ArthurSabadini/eecs3216-bldc-motor-driver/Reports/EECS 3216 Project Report.pdf

# EECS 3216 Finale Project Report: BLDC Motor Driver

### Syed Mustafa Jamal, Student Number: 217761651 Arthur Sabadini Nascimento, Student Number: 220007175 Muhammad Khan, Student Number: 218047621

### March 30 - April 21, 2025

1

## Contents

1 Abstract | 4
2 Analysis Correction | 5
3 Helper Modules | 6
4 Software Design | 11
5 Hardware Design | 20
6 Components | 23
7 Simulations | 24
8 Testing | 26
9 Implemented Circuit | 34
10 Challenges | 35
11 Measurements | 36

2

12 Addressing the Damping Effect | 38
13 Conclusion | 38
References | 39
14 External Resources | 40

3

## Abstract

Our project is about a driver for a three-phase BLDC motor. We will implement SVPWM (space vector PWM) to control the three phases of the motor. We will also implement an inverter with discrete components (capacitors, transistors, flyback diodes, etc) in order to demonstrate the driver working, using an RC low-pass filter and oscilloscope probes.

Our project operates on the software side, where we generate three distinct PWM signals using the SVPWM algorithm to maximize the power delivered to the load. These PWM signals would be fed to an inverter (we implemented that with discrete components), and the inverter would control a higher voltage source to deliver more power to the motor (our load) to drive it. As described before, the internal impedance of the motor behaves as a low-pass filter, so the output of the inverter is converted to a sinusoidal input to the motor.

4

## Analysis Correction

We must address the analysis of our proposal. During testing, we noticed that the motor was moving when being driven by the system, but not completely rotating. This is because we neglected the stationary torque of the motor. Due to our approach being an open loop, the only way we could correct this was to increase the MOSFET’s (switches) gate voltage to increase the current delivered. The corrected space-state equations are

(Torque and Speed Controlling of a PMSM/BLDC Using Simulink and SOLO Blockset, 2022) [1].

d
dt

ia
ib
ic
ω

=

−R/L | 0 | 0 | −keΨa/L
0 | −R/L | 0 | −keΨb/L
0 | 0 | −R/L | −keΨc/L
keΨa/J keΨb/J keΨc/J | −B/J

ia
ib
ic
ω

+

1/L | 0 | 0 | 0
0 | 1/L | 0 | 0
0 | 0 | 1/L | 0
0 | 0 | 0 | 1/J

Va
Vb
Vc
TL

(Lee et al., 2023) [2]

Please refer to our project proposal for the full analysis. Note that now there is an extra input dependency: the motor’s load torque. We do not have the equipment to measure it, but we can remedy that in our open-loop approach by increasing the MOSFET’s gate voltage to increase the current delivered to the motor. We address the circuitry changes in the hardware design section.

5

## Helper Modules

### debouncer.sv

This module was used to debounce the input buttons Key1 and Key0, to be used as inputs in the next modules. For the following FSM, the inputs denote the button press and the completion of the debouncing period. The output is the stable signal of the button press; we denote an input that is not important as x.

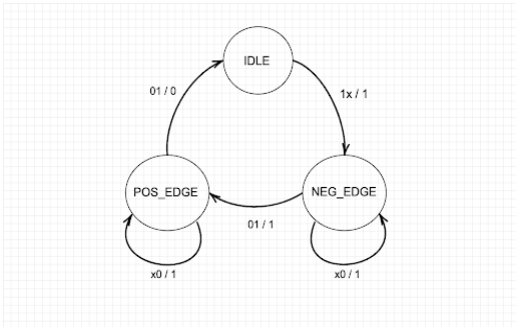
[picture p2: figure]

Figure 1: debouncer FSM

When a button is pressed, we go from IDLE to NEG EDGE, drive the output high, and keep it in NEG EDGE for the duration of the debouncing period. After completion of the debouncing period, and on the next (unstable) positive edge of the button, we go to POS EDGE, and the functionality is the same. However, after the debouncing period is completed, we drive the output low and go back to IDLE.

6

### inputDriver.sv

This module is responsible for synchronization of the button press signals (to avoid metastability) and for detecting when both buttons are pressed at the “same” time (given a synchronization window). It is composed of four states: LISTEN, KEY0 PRESSED, KEY1 PRESSED and BOTH PRESSED. A SYNC DELAY is defined to synchronize the presses of the (debounced) inputs Key0 and Key1, we assume that if a user pressed Key0, and in the next SYNC DELAY amount of time (we chose 50ms for our usecase) also presses Key1, then we assume that the user pretended to press both buttons at the same time.

Below is the Mealy FSM design for this module. For input bits, we use Key1 = third bit, Key0 = second bit, and for the first bit we define it as 1 if the internal timer counter equals the SYNC DELAY, else if the timer is less than that we define it as 0; the timer can never be bigger than SYNC DELAY, we ensure this in the interval logic. The output is organized as Key1 Pressed, Key0 Pressed, Both keys Pressed and is used in other modules.

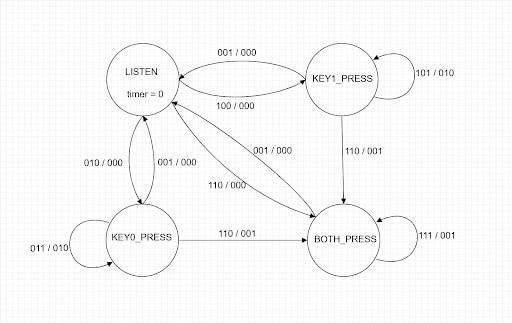
[picture p3: figure]

Figure 2: inputDriver FSM

7

The initial state is always LISTEN, where we wait for input. Suppose the user pressed Key1, then we would go to state KEY1 PRESS and wait for the timer to equal SYNC DELAY. If the user keeps pressing the same key until then, we stay in the current state KEY1 PRESS and update the output to 010, which represents that key1 has been pressed. Else, if before that, the user also presses key0, the FSM will transition to BOTH PRESS, updating the output to 001, representing that both keys have been pressed. When the user releases any buttons, after some synchronization delay, the module will return to the LISTEN state, waiting for new inputs.

8

### Driver.sv

This module was used to interact with a user, get inputs, modify the parameters of the generated signals, such as frequency, amplitude, and dead time, and turn the signal on and off. There are three possible configurations: Frequency configuration, Amplitude configuration and Dead Time configuration, together with two input buttons Key1 and Key0.

When Key0 is pressed, the module changes the value according to the current configuration (i.e. if in Frequency configuration, it changes the signal’s frequency), and Key1 is used to activate/deactivate the output signal. When both keys are pressed (for this we used the previously explained module inputDriver.sv), the module goes to the next configuration; from Frequency to Amplitude, Amplitude to Dead Time, and Dead Time back to Frequency.

Options are 3Hz, 5Hz, 6Hz, 7Hz and 8Hz.

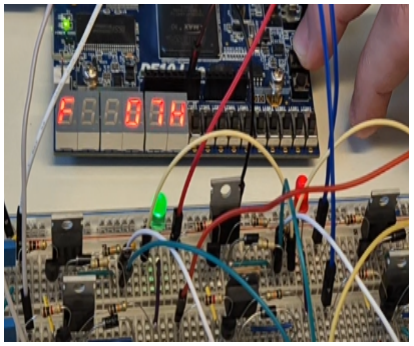
[picture p4: figure]

Figure 3: Frequency Configuration UI

9

Options are 20%, 40%, 60%, 80% and 100%.

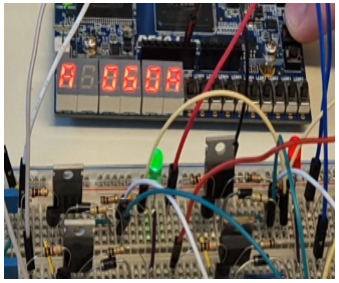
[picture p5: figure]

Figure 4: Amplitude Configuration UI

Options are 300ns, 500ns, 700ns, 1us and 3us.

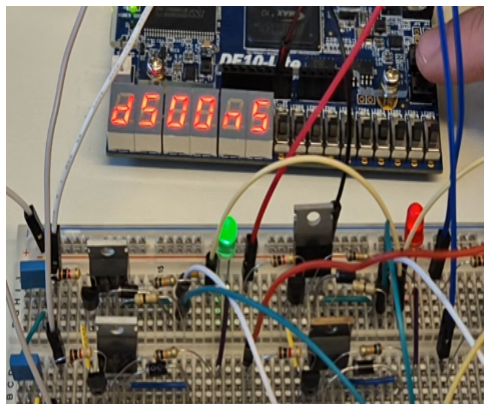
[picture p6: figure]

Figure 5: Dead Time Configuration UI

10

## Software Design

### Algorithm Explanation

We chose to implement the Space Vector Pulse Width Modulation (SVPWM) algorithm for this project. In SVPWM, instead of generating sinusoidal PWM signals offset by 120 degrees, the duty cycle and period of the outputs are controlled by a sector and a corresponding (preset) vector sequence.

Each sector corresponds to 6 sectors (of 60 degrees each) of a circle, the space vectors correspond to the codified output of the three phases (i.e. for a vector = 100, output 1 is high and outputs 2 and 3 are low).

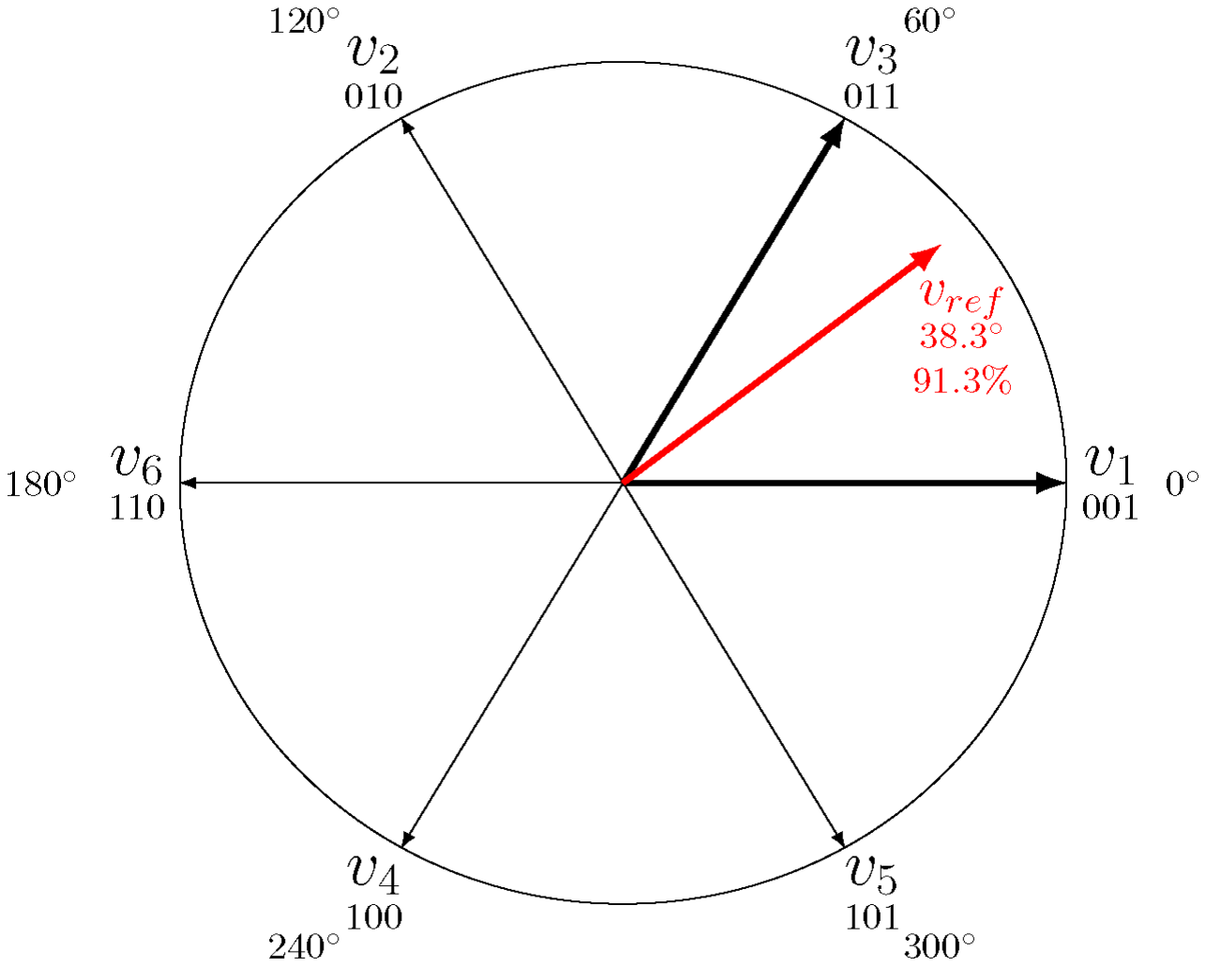
[picture p7: figure]

Figure 6: (Space Vector PWM Intro, 2017) [10]

Using a look-up table with sine wave values, we can use the SVPWM algorithm to represent any voltage vector in the above diagram (limited by the look-up table resolution)! The SVPWM algorithm was chosen (instead of SPWM) because it can maximize the power delivered to the load; SPWM can deliver 50% of power, while SVPWM, 86%

The output of this module is labelled S; the first three LSBs (bits 0 - 2) are the top output of the inverter, and the last three MSBs (bits 5 - 3) are the reversed lower outputs of the inverter. The outputs are arranged so that the inverse of bit 0 is bit 3, bit 1 is bit 4, and bit 2 is bit 5.

11

### Implementation

We created a module SVPWM.sv, which takes 5 inputs, 3 of which are amplitude, frequency and dead time configurations. This module was responsible for generating the 3 outputs and their inverse counterparts with dead time (so as not to short the power supply).

1 | module SVPWM (
2 | input wire clk ,
3 | input wire active ,
4 | input wire [6:0] AMPLITUDE ,
5 | input wire [13:0] FREQ ,
6 | input wire [13:0] DEAD_TIME_US ,
7 | output reg [5:0] S
8 | );
Listing 1: Module Definition

We had to sample a base sine wave to implement an open-loop system. For that, we created a sine look-up table with 102 samples (the reason why 102 specifically will be explained shortly).

15 | // Samples at 1 kHz . Normalized in units of clock cycle at 50 MHz
16 | localparam reg [15:0] SIN_LUT [0: SAMPLES -1] = ’{
17 | 16 ’ d24999 , 16 ’ d26538 , 16 ’ d28071 , 16 ’ d29593 , 16 ’ d31097 , 16 ’ d32578 , 16 ’
d34030 , 16 ’ d35448 , 16 ’ d36826 , 16 ’ d38160 , 16 ’ d39443 , 16 ’ d40672 ,
18 | 16 ’ d41841 , 16 ’ d42946 , 16 ’ d43984 , 16 ’ d44949 , 16 ’ d45839 , 16 ’ d46649 , 16 ’
d47378 , 16 ’ d48021 , 16 ’ d48577 , 16 ’ d49044 , 16 ’ d49420 , 16 ’ d49703 ,
19 | 16 ’ d49892 , 16 ’ d49987 , 16 ’ d49987 , 16 ’ d49892 , 16 ’ d49703 , 16 ’ d49420 , 16 ’
d49044 , 16 ’ d48577 , 16 ’ d48021 , 16 ’ d47378 , 16 ’ d46649 , 16 ’ d45839 ,
20 | 16 ’ d44949 , 16 ’ d43984 , 16 ’ d42946 , 16 ’ d41841 , 16 ’ d40672 , 16 ’ d39443 , 16 ’
d38160 , 16 ’ d36826 , 16 ’ d35448 , 16 ’ d34030 , 16 ’ d32578 , 16 ’ d31097 ,
21 | 16 ’ d29593 , 16 ’ d28071 , 16 ’ d26538 , 16 ’ d24999 , 16 ’ d23460 , 16 ’ d21927 , 16 ’
d20405 , 16 ’ d18901 , 16 ’ d17420 , 16 ’ d15968 , 16 ’ d14550 , 16 ’ d13172 ,
22 | 16 ’ d11838 , 16 ’ d10555 , 16 ’ d9326 , 16 ’ d8157 , 16 ’ d7052 , 16 ’ d6014 , 16 ’
d5049 , 16 ’ d4159 , 16 ’ d3349 , 16 ’ d2620 , 16 ’ d1977 , 16 ’ d1421 ,
23 | 16 ’ d954 | , 16 ’ d578 | , 16 ’ d295 | , 16 ’ d106 | , 16 ’ d11 | , 16 ’ d11 | , 16 ’
d106 | , 16 ’ d295 | , 16 ’ d578 | , 16 ’ d954 | , 16 ’ d1421 , 16 ’ d1977 ,
24 | 16 ’ d2620 , 16 ’ d3349 , 16 ’ d4159 , 16 ’ d5049 , 16 ’ d6014 , 16 ’ d7052 , 16 ’
d8157 , 16 ’ d9326 , 16 ’ d10555 , 16 ’ d11838 , 16 ’ d13172 , 16 ’ d14550 ,
25 | 16 ’ d15968 , 16 ’ d17420 , 16 ’ d18901 , 16 ’ d20405 , 16 ’ d21927 , 16 ’ d23460
26 | };
Listing 2: Sine Look-Up Table

12

FSMs

There were two FSMs in the SVPWM module, one FSM for each sector and another for each vector.

28 | typedef enum logic [2:0] { S1 , S2 , S3 , S4 , S5 , S6 } state_sector ;

29
30 | typedef enum logic [2:0] {
31 | V0 = 3’ b000 , V1 = 3’ b100 , V2 = 3 ’ b110 , V3 = 3’ b010 ,
32 | V4 = 3’ b011 , V5 = 3’ b001 , V6 = 3 ’ b101 , V7 = 3’ b111
33 | } state_vector ;
Listing 3: Sector and Vector FSM

We defined a look-up table for the vector sequence for each sector. Each sequence was chosen so only 1 bit is changed on each vector transition. This was needed to minimize switching losses on the MOSFETs and BJTs transistors.

35 | localparam state_vector SECTOR_VECTORS_LUT [0: NUMBER_STATES -1][0:
| NUMBER_VECTORS -1] = ’{
36 | ’{V0 , V1 , V2 , V7 , V2 , V1 , V0 }, ’{V0 , V3 , V2 , V7 , V2 , V3 , V0 } ,
37 | ’{V0 , V3 , V4 , V7 , V4 , V3 , V0 }, ’{V0 , V5 , V4 , V7 , V4 , V5 , V0 } ,
38 | ’{V0 , V5 , V6 , V7 , V6 , V5 , V0 }, ’{V0 , V1 , V6 , V7 , V6 , V1 , V0 }
39 | };
Listing 4: Vectors Sequence

13

Parameters Calculations

As mentioned in our proposal, the time allocated to each vector in a sequence goes as

T1 =

Ts √
3

sin(θ − π/3)

T2 =

Ts √
3

sin(θ)

T3 = Ts − (T1 + T2)

We implemented these values in the software as follows

58 | // SVPWM parameters calculations
59 | reg [6:0] TIME = 0;
60 | reg [17:0] AMP ;
61 | reg [32:0] T0 , T1 , T2 ;

62
63 | // Normalizing by 100 and Dividing by sqrt {3}
64 | // Note 2^19 */(100* sqrt {3}) = 0 xBD2
65 | assign AMP = ( AMPLITUDE * SAMPLE_PERIOD * 40 ’ hBD2 ) >> 19;

66
67 | // Normalizing by max SIN_LUT value = 49999
68 | assign T1 = AMP * SIN_LUT [ TIME % SAMPLES ] / 49999;
69 | assign T2 = AMP * SIN_LUT [( TIME + ( SAMPLES * 120 / 360) ) % SAMPLES ] /
| 49999;
70 | assign T0 = SAMPLE_PERIOD - ( T1 + T2 );
Listing 5: Periods Calculations

We defined the amplitude AMP=Ts/

√
3 where Ts is the Sample Period. To compute that in software, note that 2¹⁹/(100 ·

√
3) = 0xBD2 (we divided
by 100 to account for the variable amplitude) we multiply the input ‘AMPLI-TUDE’ by this quantity and shift back by 19 (19 was chosen to get enough precision) to compute AMP.

This was needed since the DE10-Lite board does not support floatingpoint operations. Also note that we shift the argument of ‘T2’ forwards by SAMPLES/6 since we cannot shift T1 back by the same amount; over time, this has the same effect as the original formulas.

14

State Updates

The following code is inside an ‘always comb’ block. This block is called whenever the corresponding counters are incremented.

75 | always_comb begin
76 | case ( CURR_SEC )
77 | S1 : begin
78 | NEXT_SEC = ( sector_counter < SECTOR_PERIOD )? S1 : S2 ;
79 | NEXT_VEC = SECTOR_VECTORS_LUT [0][ vector_index ];
80 | end
81 | S2 : begin
82 | NEXT_SEC = ( sector_counter < SECTOR_PERIOD )? S2 : S3 ;
83 | NEXT_VEC = SECTOR_VECTORS_LUT [1][ vector_index ];
84 | end
85 | S3 : begin
86 | NEXT_SEC = ( sector_counter < SECTOR_PERIOD )? S3 : S4 ;
87 | NEXT_VEC = SECTOR_VECTORS_LUT [2][ vector_index ];
88 | end
89 | S4 : begin
90 | NEXT_SEC = ( sector_counter < SECTOR_PERIOD )? S4 : S5 ;
91 | NEXT_VEC = SECTOR_VECTORS_LUT [3][ vector_index ];
92 | end
93 | S5 : begin
94 | NEXT_SEC = ( sector_counter < SECTOR_PERIOD )? S5 : S6 ;
95 | NEXT_VEC = SECTOR_VECTORS_LUT [4][ vector_index ];
96 | end
97 | S6 : begin
98 | NEXT_SEC = ( sector_counter < SECTOR_PERIOD )? S6 : S1 ;
99 | NEXT_VEC = SECTOR_VECTORS_LUT [5][ vector_index ];
100 | end
101 | endcase
Listing 6: State Updates

We can see that the update of ‘NEXT SEC’ and ‘NEXT VEC’ is based on a straightforward type II state machine. ‘NEXT PREDICT VEC’is used for the dead time implementation, This will be explained shortly.

In the same block, the top output of the inverters defined as

109 | // Inverting ( top ) Output
110 | // If not active (on an emergency stop for example ) hard set top values
| to 1 to turn off
111 | S [2:0] = active ? ~ CURR_VEC : 3’ b111 ;
112 | end
Listing 7: Top Output

If we are in the active state (‘active’ is an input to the module), the top output is the inverted current vector; we inverted the logic after implementing a voltage shifter circuit, which will be covered in the hardware section.

15

Vector Period Calculations

Vector periods are the periods in which each vector must be active. The following code shows how we implemented it.

117 | // Period Update
118 | always_comb begin
119 | case ( vector_index )
120 | 0: VECTOR_PERIOD = T0 / 4;
121 | 1: VECTOR_PERIOD = T1 / 2;
122 | 2: VECTOR_PERIOD = T2 / 2;
123 | 3: VECTOR_PERIOD = T0 / 2;
124 | 4: VECTOR_PERIOD = T2 / 2;
125 | 5: VECTOR_PERIOD = T1 / 2;
126 | 6: VECTOR_PERIOD = T0 / 4;
127 | default : VECTOR_PERIOD = T0 / 4;
128 | endcase
129 | end
Listing 8: Period Updates

In the above code, we allocated the first, middle and last vectors as zero vectors, no current will be flowing during the time allocated for T0. We can also see that the second, third, fifth and sixth vectors are active. This time allocation would allow us to generate the following voltage diagram (for the first sector, S1).

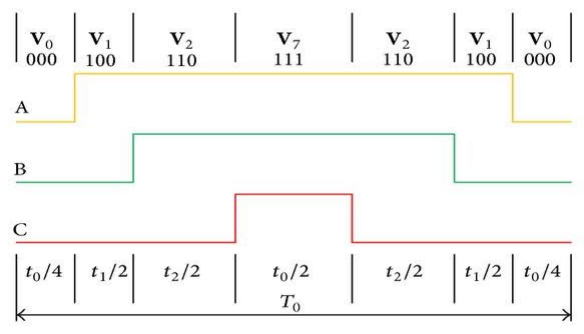
[picture p8: figure]

Figure 7: (Switching Sequence of Traditional SVPWM., n.d.) [10]

A similar voltage pattern would be implemented for each sector, however, the voltage distribution would change.

16

State Transitions

If the user presses the (debounced) reset button on its negative edge, we immediately deactivate the lower outputs of the inverter (bits 3- 5) by writing 1s to them (due to the inverted logic); this would turn off the whole operation. Else, while we are active, we keep incrementing the counters and other parameters normally.

131 | // States Transitions
132 | always_ff @( posedge clk or negedge active ) begin
133 | if (~ active ) begin
134 | // If not active (on an emergency stop for example ) hard set bottom
| values to 1 to turn off
135 | S [5:3] <= 3’ b111 ;
136 | end else begin
137 | sector_counter <= ( sector_counter < SECTOR_PERIOD )? sector_counter +
| 1: 0;

138
139 | // Forcefully reset parameters
140 | // Output may be out of sync if frequency is not a divisor of system
| clock (50 MHz )
141 | if (( sample_counter >= SAMPLE_PERIOD ) | ( sector_counter >=
| SECTOR_PERIOD ) ) begin
142 | vector_counter <= 0;
143 | vector_index <= 0;
144 | sample_counter <= 0;
145 | TIME <= ( TIME + 1) % SAMPLES ;
Listing 9: State Transitions

We reset parameters when transitioning between samples and sectors. This answers why we chose an oddly specific number of samples at the beginning of the report (102 sine lut samples). Since we have 6 sectors, we’d like to go through an equal number of samples per sector.

On the positive edge of the clock, we update the parameters normally. We increment ‘vector counter’ until it reaches ‘VECTOR PERIOD’, we only increment the vector index when a vector period is finished.

147 | // Incrementing parameters
148 | end else begin
149 | vector_counter <= ( vector_counter < VECTOR_PERIOD )? vector_counter +
| 1: 0;
150 | sample_counter <= sample_counter + 1;

151
152 | // Only increment vector_index at the end of the vector period
153 | if( vector_counter >= VECTOR_PERIOD ) vector_index <= ( vector_index +
1) % ( NUMBER_VECTORS );
154 | end
Listing 10: Parameter Updates

17

Dead Time

Dead time is the period in which both the top and bottom outputs of the inverter are off, so that we may avoid shorting the power supply. To implement this, we must know what the next vector is in the sequence.

If the next bit is a 1, and the current signal is also a 1, this signal must be flipped to a 0 before the vector transition so as not to short the power supply.

156 | // Dead Time I m p l e m e n t a t i o n for Non - Inverting ( bottom ) Output
157 | // Fist output is undefined , implement a pull down resistor .
158 | if( vector_counter >= ( VECTOR_PERIOD - ( DEAD_TIME_PERIOD ) )) begin
159 | // Initially both signals ( top and bottom ) are 0 , and suppose the
| top output
160 | // goes to 1 at the beggining of a vector transition . The bottom
| signal waits for
161 | // D E A T _ T I M E _ P E R I O D / 2 at the end of the cycle and makes a
| prediction of what the next vector will be
162 | // ( really we know what it is since the vector sequence is fixed ).
163 | // If the prediction is correct we assign the vector value to the
| bottom output
164 | // ( since the top output is inverted ) else we set it to 0 for safety

165
166 | S [3] <= ( NEXT_PREDICT_VEC [0] == CURR_VEC [0]) ? NEXT_PREDICT_VEC [0]:
| 0;
167 | S [4] <= ( NEXT_PREDICT_VEC [1] == CURR_VEC [1]) ? NEXT_PREDICT_VEC [1]:
| 0;
168 | S [5] <= ( NEXT_PREDICT_VEC [2] == CURR_VEC [2]) ? NEXT_PREDICT_VEC [2]:
| 0;
169 | end else if( vector_counter >= DEAD_TIME_PERIOD ) begin
170 | // After the initial D E A D _ T I M E _ P E R I O D we set the bottom output to
| the current vector value
171 | // ( since top output is inverted ).
172 | S [5:3] <= CURR_VEC ;
173 | end
Listing 11: Dead Time Implementation

18

There are two important moments for the dead time signals. When the counter reaches ‘VECTOR PERIOD - DEAD TIME PERIOD’, this is the end of the previous cycle, where we must ‘predict’ what the next output is going to be.

If the prediction is equal to the current value of the signal, we make no changes, we reset to 0. The other important moment is the the counter reaches ‘DEADT TIME PERIOD’ in the beginning of the cycle, in which the dead time has completed, so we can invert the current value of the top signal and write it to the lower signal (since the output is inverted, the lower signals equals the bits of the current vector). The following figure best demonstrates the logic.

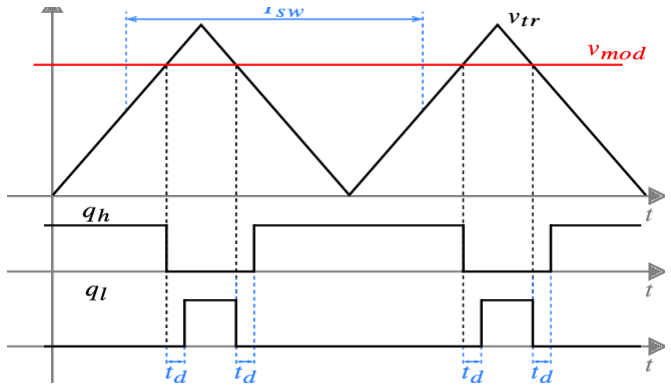
[picture p9: figure]

Figure 8: (Fig. 6. Dead-Time Generation on the Inverter Control Signals by the PWM..., n.d.) [7]

19

## Hardware Design

The hardware design was inspired by common inverter topologies, such as this one.

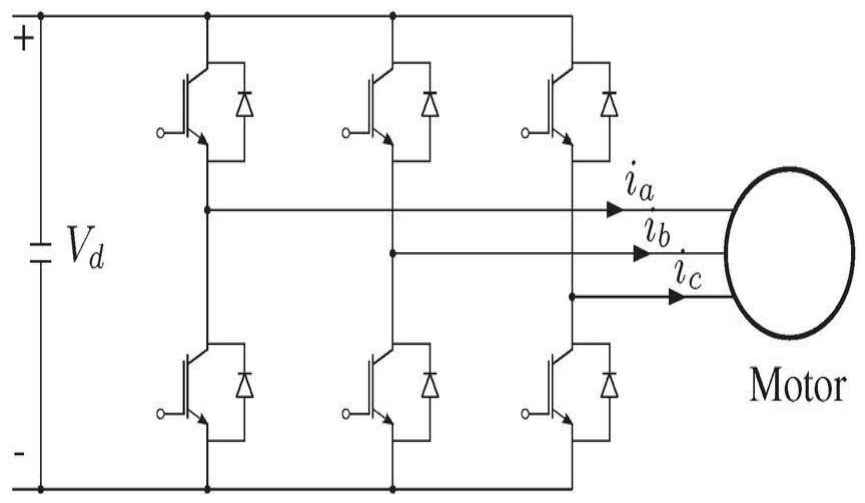
[picture p10: figure]

Figure 9: Design Topology

(Fig. 2. Three Phase Inverter Topology, n.d.) [6]

We chose the IRF520 MOSFET to act as switches (in the saturation region) since the DE10-Lite can’t provide enough current to operate BJTs. MOSFETs can handle higher currents, which are needed to drive the motor. The following was our initial circuit design.

20

### Previous Circuit Design

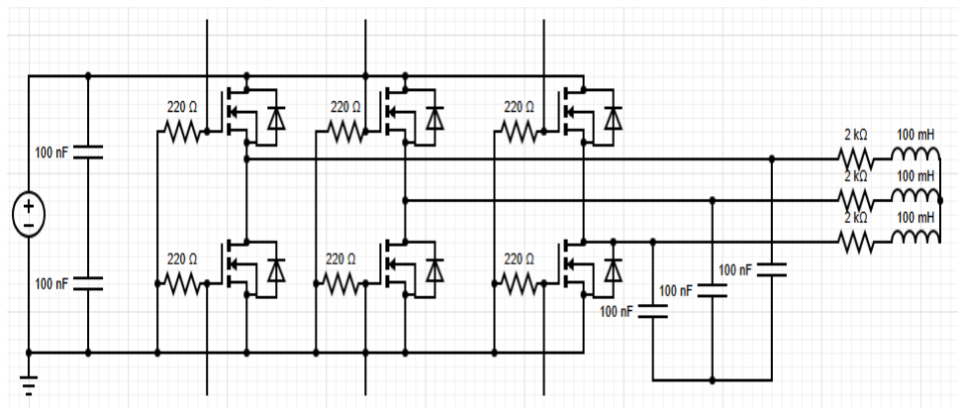
[picture p11: figure]

Figure 10: First Circuit Design

The hanging wires would be directly connected to the outputs of the DE10-Lite with the SVPWM software loaded. We implemented pull-down resistors at the gate of each MOSFET to ensure that all components would be initially off, and the three-phase resistors with inductors connection simulate the impedance of the motor, the diodes across the MOSFETs are to ensure that the back EMF of the motor do not damage the MOSFETs; even though they already have built in reverse diodes, we did not know what the magnitude of the back EMF could be, so we added the diodes for redundancy. We also implemented the capacitors connected in a star configuration; those were mostly used for debugging and visualizing the raw output waves.

21

### Improved Circuit Design

The circuitry mostly worked, however, we noticed that we were not getting enough current through the motor, and as a result, the motor did not fully move. This was the case because the voltage logic level of the DE10-Lite (3.3V) was too low to turn on the MOSFETs completely. For this reason, we decided to add extra circuitry to the MOSFETs gate input to shift up the voltage. Follows the improved (and final) circuitry.

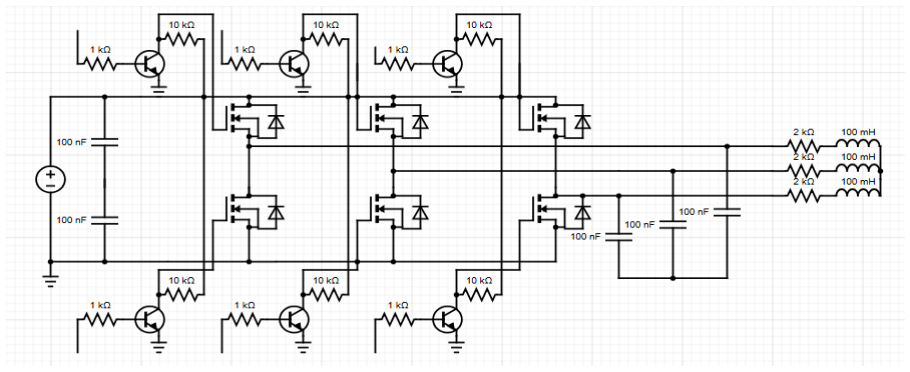
[picture p12: figure]

Figure 11: Final Circuit Design

The new circuitry design implements discrete NOT gates on the MOSFET inputs (hence why we reversed the logic on the software); now, there’s no need for pull-down resistors since the BJTs internal diodes already act as pull-downs. This way, we can shift the logic voltage of the DE10-Lite from 3.3V to 5V, fully turning on the MOSFETs.

This new circuitry does technically consume more power due to the not gates being on when the system is off. However, the choice of 10kOhms collector and 1KOhms base resistors was done intentionally to make sure the BJTs remain in the saturation region with a collector current of 500uA (assuming a source of 5V for the BJTs), which implies a total current consumption of 3mA when the system is off.

22

## Components

For the inverter switches, we used the IRF520 MOSFETs (Irf520.Pdf, n.d.) [8], which have an on resistance of about 0.27 Ohms and a gate voltage threshold between 2V - 4V (this is why we had to introduce extra circuitry to shift the logic voltage level of the DE10-Lite of 3.3V) the on resistance seems to be high, but on testing we noticed the MOSFETs were not heating up at all. However, the IRF520 is commonly used for high-frequency switching applications, such as for this project.

For the transistor used in the discrete not-gates, we used a combination of BC547B (alldatasheet.com, n.d.) [4] with a beta value of around 290 (which is widely used for switching applications) and the 2A2222A-1726 (P2N2222A
- Amplifier Transistors NPN Silicon, n.d.) [9] with a beta value of around 200; the 2A2222 is mostly used for amplification applications, but tests showed if would suffice for our purposes.

For the motor load, we used the CrocSee Micro 3 AC mini BLDC generator (CrocSee Micro 3 Phase AC Mini Hand Brushless Motor Generator Model Science Experiment Teaching Aid Kit DIY, Science - Amazon Canada, n.d.) [5]. It is listed as a generator, but our tests showed that it can also be used as a 3-phase motor.

Figure 12: BLDC Motor [5]

No specifications of the motor were given by the vendor. We measured the DC impedance across two legs to be around 50 ohms, which implies the DC resistance of each leg must be about 25 Ohms.

23

## Simulations

Follows a hardware simulation on the online simulator falstad.com.

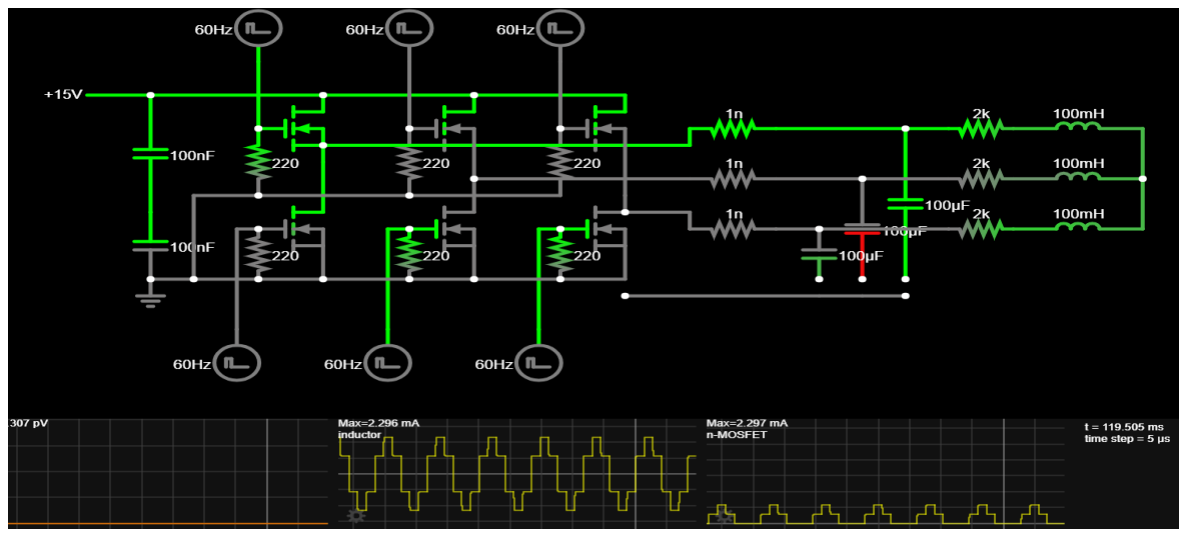
[picture p13: figure]

Figure 13: (https://tinyurl.com/26qqmcq9 n.d.) [3]

An LTspice simulation was also made. We couldn’t find the exact type of MOSFET used in our circuit; therefore, one with similar parameters was chosen. Follows the LTspice circuit and wave output.

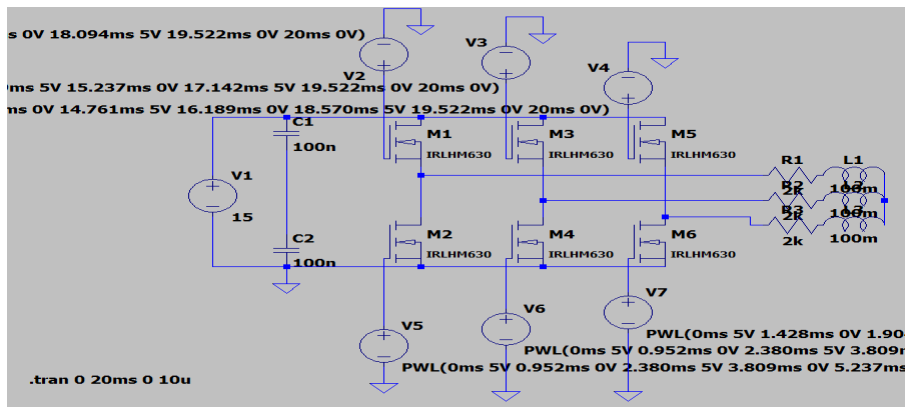
[picture p14: figure]

Figure 14: LTspice Circuit

24

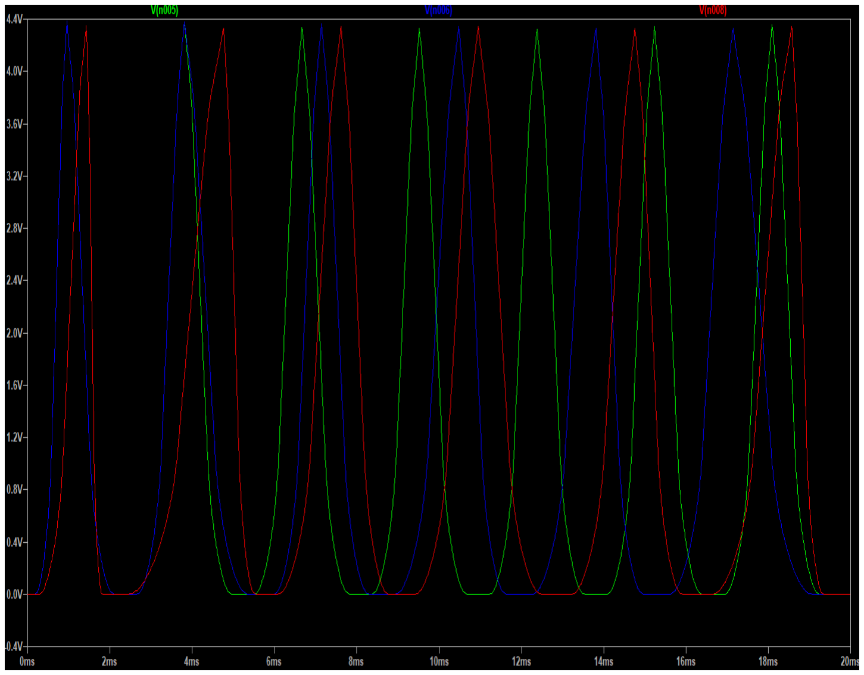
[picture p15: figure]

Figure 15: LTspice simulation output

25

## Testing

Several tests were performed on both our software and hardware throughout the semester to make sure all components were working correctly.

### Software Testing

For the software tests, we used RTL simulation and GTK Wave to visualize our signals and make sure we were implementing the SVPWM algorithm correctly. Follow the screenshots of the outputs for each sector.

Figure 16: Sector 1

Figure 17: Sector 2

26

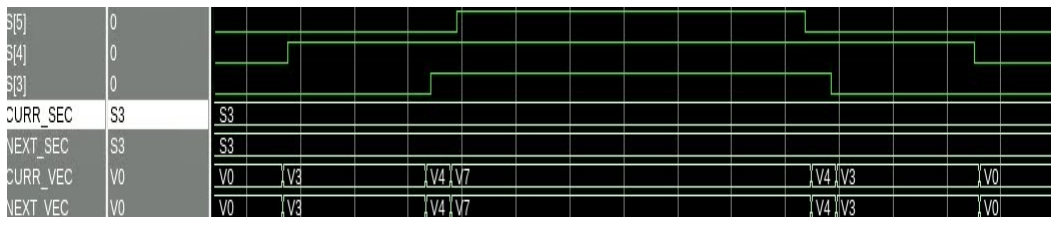
[picture p16: figure]

Figure 18: Sector 3

Figure 19: Sector 4

Figure 20: Sector 5

27

Figure 21: Sector 6

We see that all the vector sequences and signals are correct for each sector! Note that the previous waves were the reversed outputs (bits 3 - 5) for better visualization.

28

### Hardware Testing

We used the Oscilloscopes available on the Lassonde 1006 labs to visualize the waveforms and validate our outputs. However, due to the limitations of the oscilloscopes (only one math channel available), we were only able to show one wave at a time; we could not show two waves 120 degrees offset. However, the oscilloscope’s signal validated the outputs that we expected. Most signals are at 3Hz unless otherwise specified.

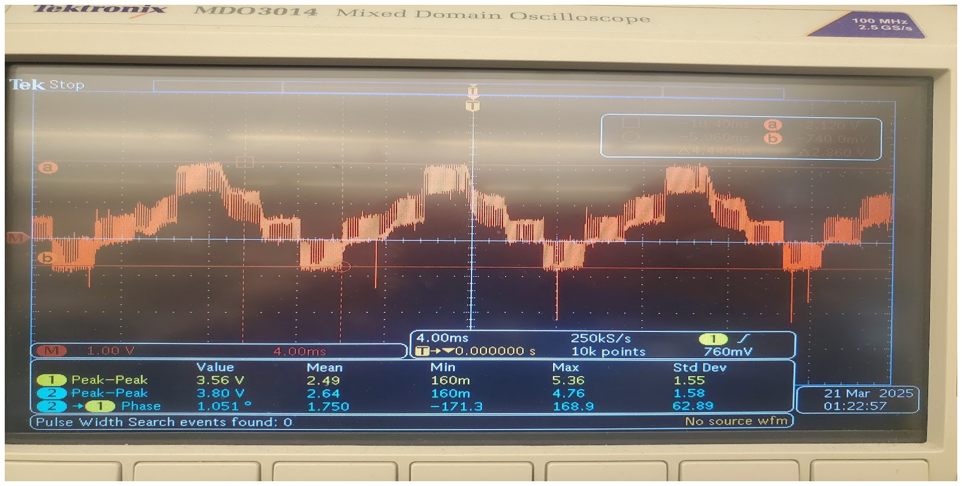
[picture p17: figure]

Figure 22:

29

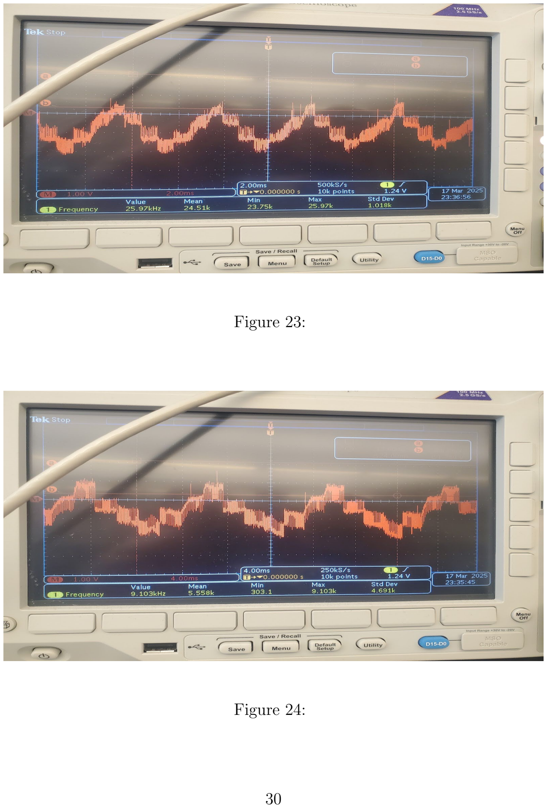
[picture p18: page 30]

Figure 23:

Figure 24:

30

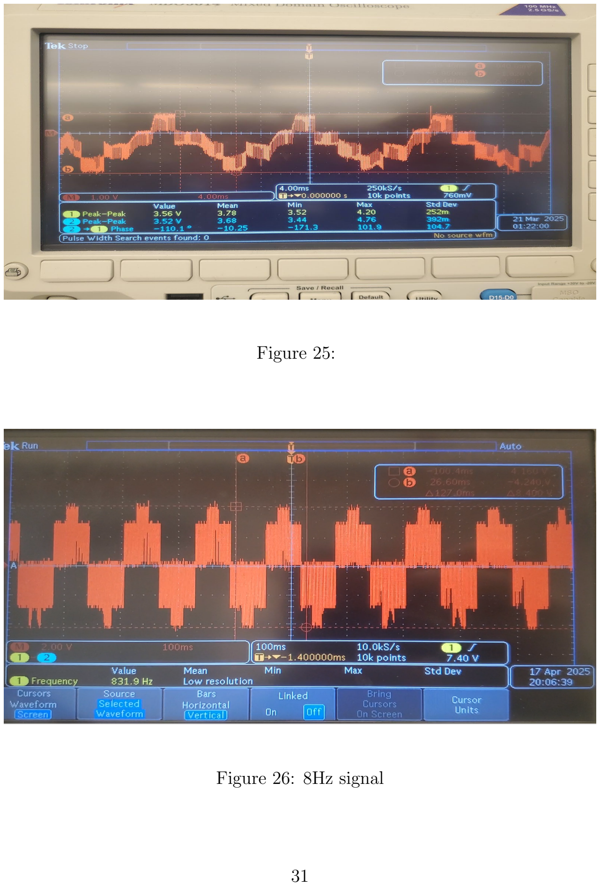
[picture p19: page 31]

Figure 25:

Figure 26: 8Hz signal

31

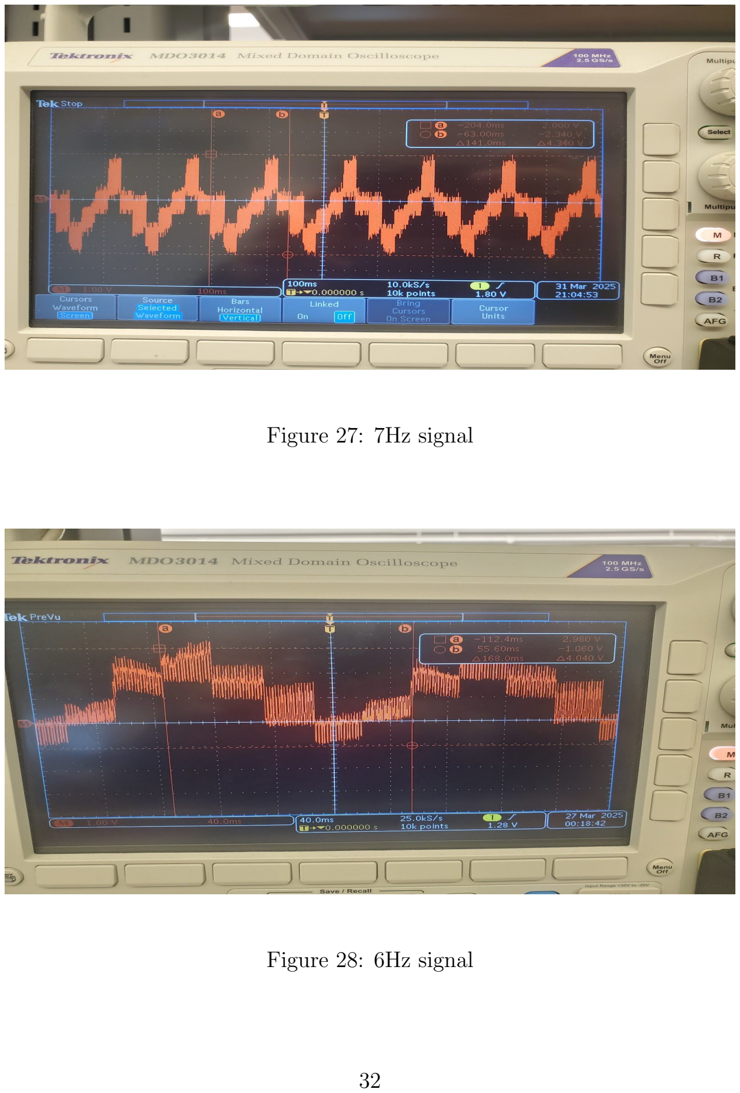
[picture p20: page 32]

Figure 27: 7Hz signal

Figure 28: 6Hz signal

32

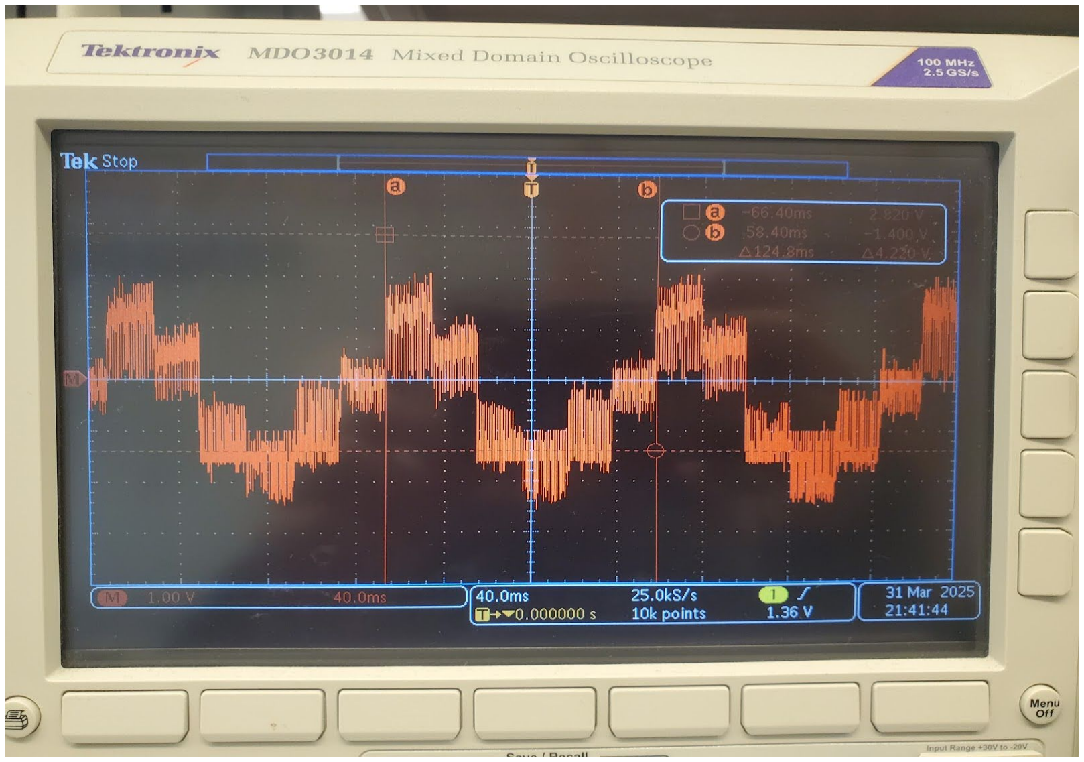
[picture p21: figure]

Figure 29: 8Hz signal

Note that the waveforms are supposed to be rectangular; this is normal for inverter outputs. When the output is connected through a motor, then the high-frequency digital waveforms are filtered out, and the signals become sinusoidal.

33

## Implemented Circuit

Here, we show some pictures of the implemented hardware setup.

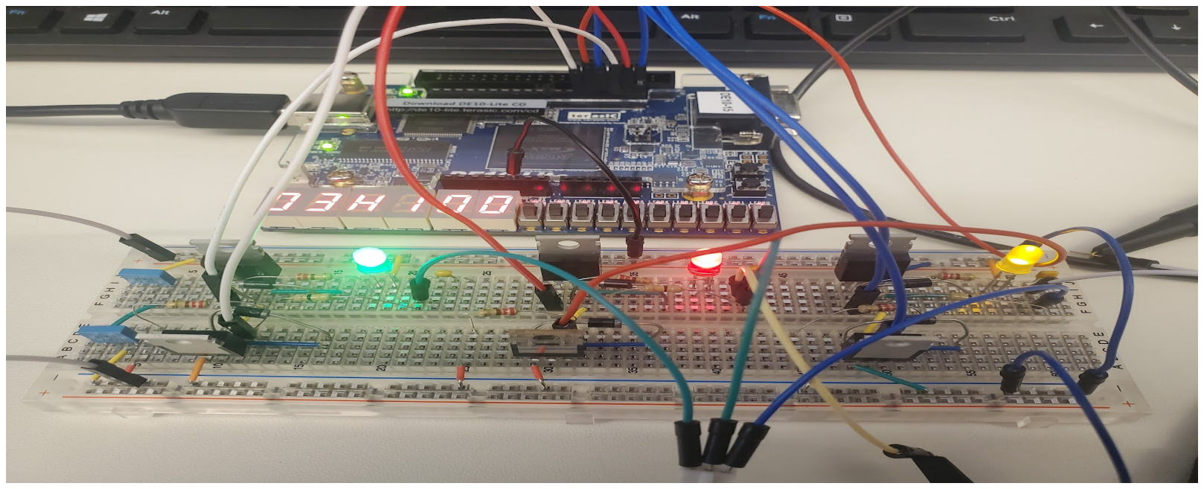
[picture p22: figure]

Figure 30: No Load

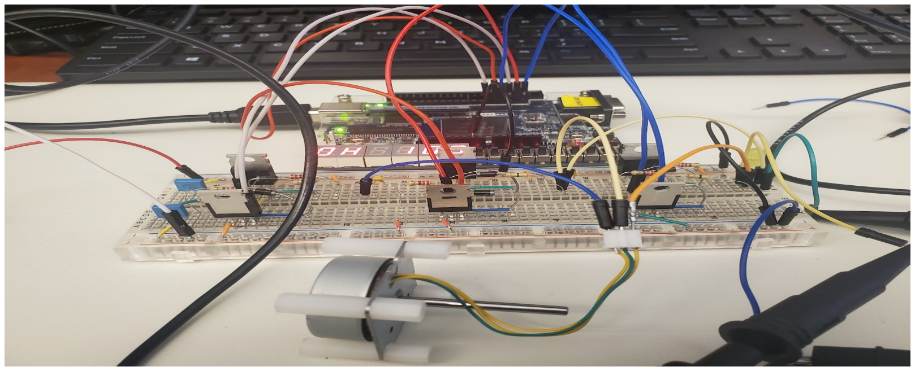
[picture p23: figure]

Figure 31: With Motor Load

34

## Challenges

### Software Challenges

On the software side, the challenges were to research the SVPWM algorithm and read papers to understand it and implement it in System-Verilog. We checked various papers on the subject, which were very helpful for software development.

Another challenge in the software development was that we needed module parameters with huge sizes to account for the low frequencies used. We fixed this by compromising by reducing the length of other parameters that were not so crucial.

We noticed that having a total number of samples that was not a divisor of 6 introduced desynchronized behaviour to the waveforms, specifically on vector transitions. We fixed this by having a total number of samples divisible by 6; this way, we could go through an equal number of samples per sector and keep the synchronization.

### Hardware Challenges

However, most of the challenges we experienced were on the hardware side. The first challenge was that the logic voltage level of the DE10-Lite is only 3.3V, which is quite low; we could not get sufficient power and current in the inverter output.

Another challenge we had was with one of the group members’ personal DE10-Lite board; when none of us were touching it, it turned off and began making a sound. When checking with the lab technician, he mentioned it could’ve been an issue with the power adapter and that it would be hard to reverse engineer the actual issue; we continued working on the project with the lab boards.

35

## Measurements

Several measurements were made during the development of the project. Follows the oscilloscope traces taken across the legs of the motor.

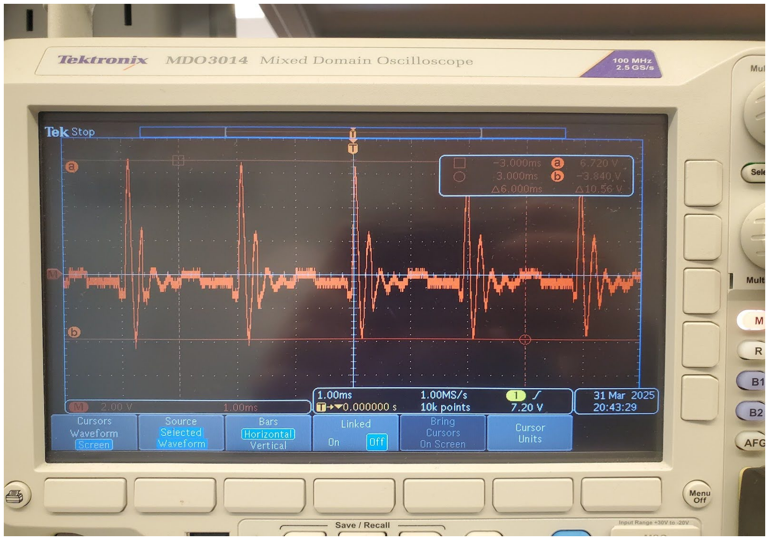
[picture p24: figure]

Figure 32:

36

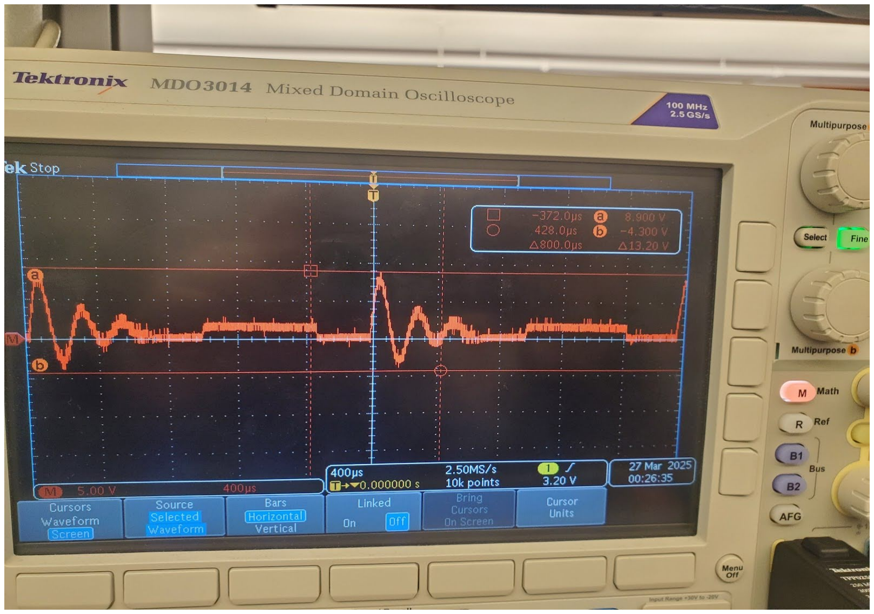
[picture p25: figure]

Figure 33:

We can see that the voltage waves are sinusoidal as intended! Note also that the voltage amplitude is about 13.2V,(this is quite close to 86% of the 15V supply (13V)), which is the power that the SVPWM algorithm should supply!

37

## Addressing the Damping Effect

We can observe on the waveforms and measurements that the sinusoidal waves are damped. This, at first, was due to the low MOSFETs gate voltage, which was not providing enough current to be applied through the motor. After the new circuit design, we were able to successfully drive the motor with more power, however, we damaged some of the MOSFETs while doing so. However, even with some damaged MOSFETs, we can see that the output waveforms are correct for the SVPWM algorithm, and we can even drive the motor to rotate sideways!

## Conclusion

In conclusion, we were able to implement the SVPWM algorithm in System-Verilog successfully. The implemented software was uploaded to the DE10-Lite FPGA and connected to an inverter circuit, which was implemented by us using discrete components. We performed multiple analyses and tests throughout the development of the project to verify its functionality and outputs. We were able to successfully drive a BLDC motor (and LEDs) to demonstrate the functionality of the project.

38

## References

[1] Torque and Speed Controlling of a PMSM/BLDC using Simulink and SOLO Blockset. Section: Simulink. July 8, 2022. url: https://www.solomotorcontrollers.com/blog/torque- speed- control- pmsmbldc-simulink/ (https://www.solomotorcontrollers.com/blog/torque-speed-control-pmsm-bldc-simulink/) (visited on 04/07/2025).
[2] Ung Hee Lee et al. How to Model Brushless Electric Motors for the Design of Lightweight Robotic Systems. Sept. 29, 2023. doi: 10.48550/ arXiv.2310.00080. (https://doi.org/10.48550/arXiv.2310.00080) arXiv: 2310.00080[cs]. url: http://arxiv.org/abs/2310.00080 (http://arxiv.org/abs/2310.00080) (visited on 04/07/2025).
[3] url: https://tinyurl.com/26qqmcq9 (visited on 04/01/2025).
[4] alldatasheet.com. BC547B PDF. url: http://www.alldatasheet.com/datasheet-pdf/view/2894/MOTOROLA/BC547B.html (http://www.alldatasheet.com/datasheet-pdf/view/2894/MOTOROLA/BC547B.html) (visited on 04/07/2025).
[5] CrocSee Micro 3 Phase AC Mini Hand Brushless Motor Generator Model Science Experiment Teaching Aid Kit DIY, Science - Amazon Canada. url: https://www.amazon.ca/CrocSee- Brushless-Generator-Experiment-Teaching/dp/B0722Z4PX5/ref=mp_s_a_1_ 16?crid=NR9Z957CI2PG&dib=eyJ2IjoiMSJ9.R3n7IAd5zG8fNZtGsPhm2kbe9qUnuM66vET_ yN8wJz1qKeQshSJzvka-IN0B2Z8Y8jZZU9KFCaeagGRDtAZJ3dBrxZ7DRmsiwphBnW7khIIQFgXFqFoY2fR2CwZTW_ kRUuhkva5mfzgSRn2cGpcgF0cEPrqXHdHNfJ5KR5zSvXLt2gEeCU5F01fhOWdq5x286jLiiduomr4Y00tyCQ1fAA. bFgRx9OeWBQ9 _ HXhzY4LBEzV _ F7rqDmlzgoY _ ZTUh _ Q & dib _ tag = se &
keywords = 3 + phase + motor & qid = 1740762280 & sprefix = 3 + phase +
motor%2Caps%2C90&sr=8-16 (https://www.amazon.ca/CrocSee-Brushless-Generator-Experiment-Teaching/dp/B0722Z4PX5) (visited on 04/07/2025).
[6] Fig. 2. Three phase inverter topology. ResearchGate. url: https://www.researchgate.net/figure/Three-phase-inverter-topology_fig1_317297464 (https://www.researchgate.net/figure/Three-phase-inverter-topology_fig1_317297464) (visited on 04/07/2025).
[7] Fig. 6. Dead-time generation on the inverter control signals by the PWM... ResearchGate. url: https://www.researchgate.net/figure/Dead-time-generation-on-the-inverter-control-signals-bythe-PWM-technique_fig3_365902774 (https://www.researchgate.net/figure/Dead-time-generation-on-the-inverter-control-signals-by-the-PWM-technique_fig3_365902774) (visited on 04/06/2025).
[8] IRF520 - Power MOSFET NPN Silicon. url: https://www.vishay.com/docs/91017/irf520.pdf (https://www.vishay.com/docs/91017/irf520.pdf) (visited on 04/07/2025).
[9] “P2N2222A - Amplifier Transistors NPN Silicon”. In: ().
[10] Switching sequence of traditional SVPWM. ResearchGate. url: https: / / www . researchgate . net / figure / Switching - sequence - of -traditional-SVPWM_fig3_301718871 (https://www.researchgate.net/figure/Switching-sequence-of-traditional-SVPWM_fig3_301718871) (visited on 04/07/2025).

39

## External Resources

All design files and proposal reports can be found in this (https://github.com/ArthurSabadini/eecs3216-bldc-motor-driver) GitHub directory (https://github.com/ArthurSabadini/eecs3216-bldc-motor-driver), and the demonstration video can be found here. (https://www.youtube.com/watch?si=b8xfoCtHZS__AAA1&v=ajDVEePGOGo&feature=youtu.be)

(https://youtu.be/ajDVEePGOGo?si=b8xfoCtHZS AAA1).

40
