ArthurSabadini/eecs3216-bldc-motor-driver/(commit log)

2025-04-03 Changing to inverting logic on outputs
    [SVPWM.sv]
2026-04-12 Update and rename Driver.sv to TopLevel.sv
