ArthurSabadini/eecs3216-bldc-motor-driver/(notices)

Notices in the files:
README.md:
License:
[MIT License](https://choosealicense.com/licenses/mit/)
